robert-cameron/jenga_bot/embedded/end_eff_1.png

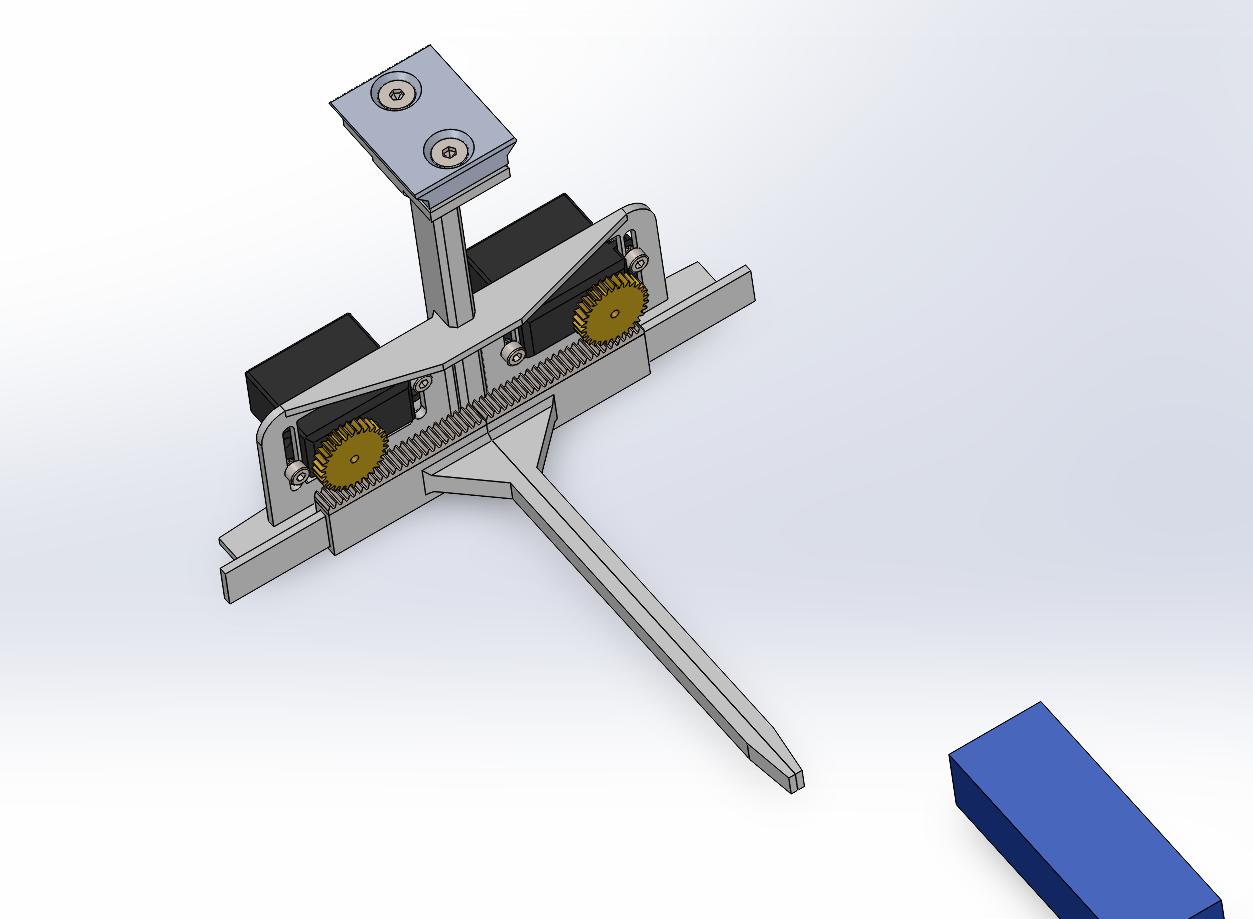
embedded/end_eff_1.png
