robert-cameron/jenga_bot/embedded/end_eff_2.png

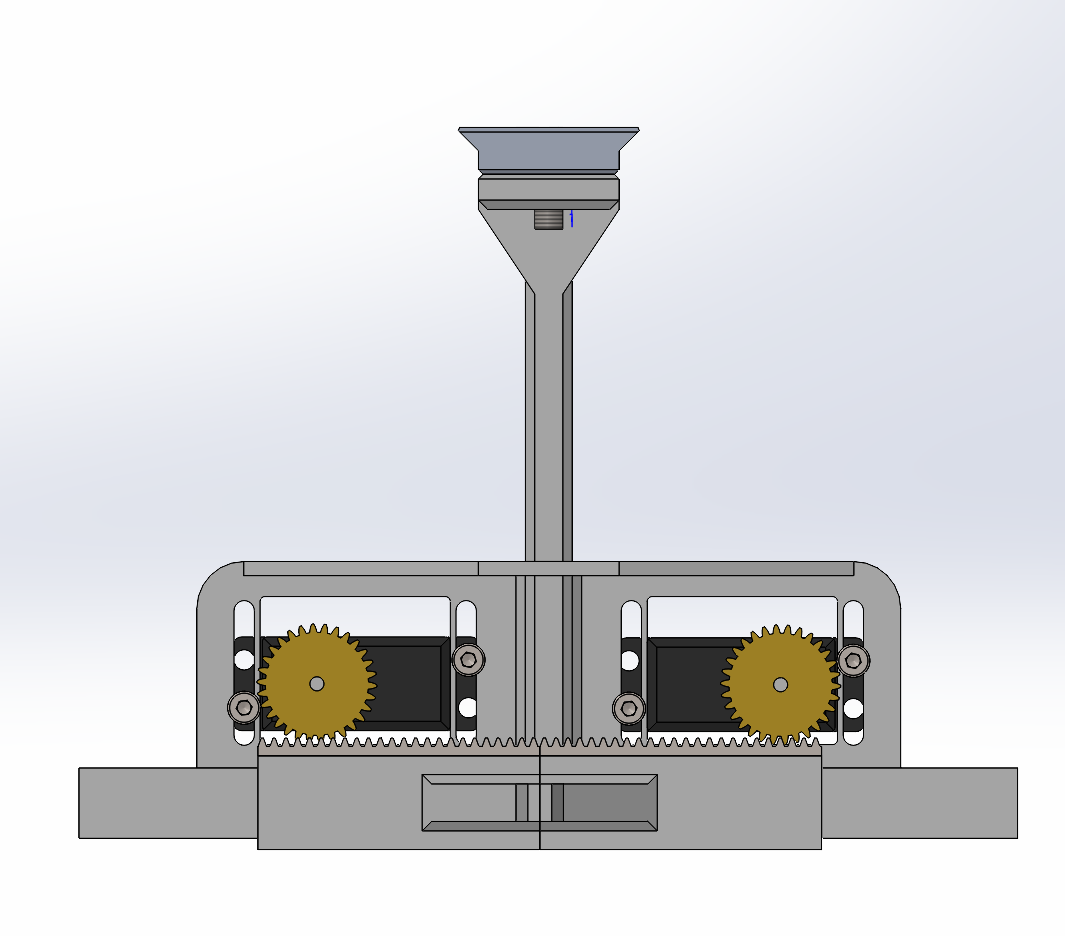
embedded/end_eff_2.png
