robert-cameron/jenga_bot/embedded/end_eff_3.png

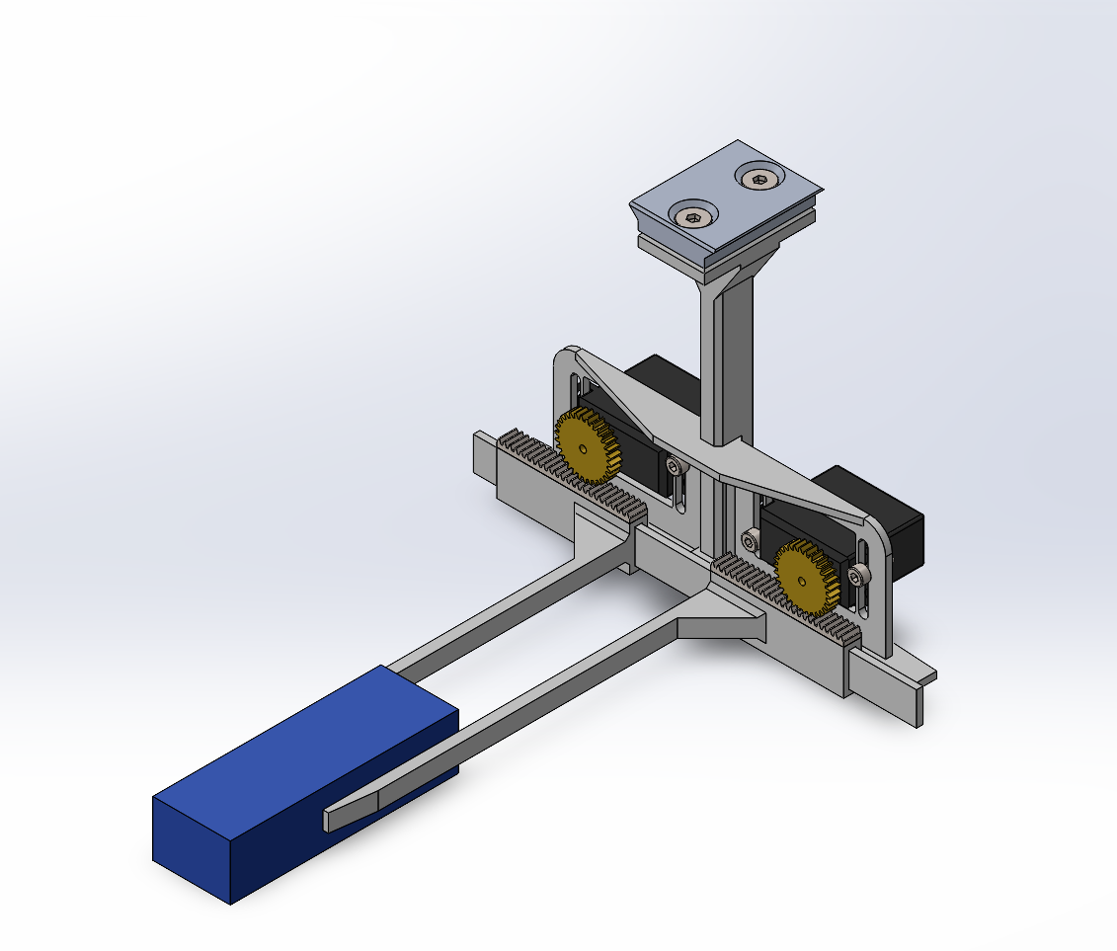
embedded/end_eff_3.png
