robert-cameron/jenga_bot/image/state_diagram_2.png

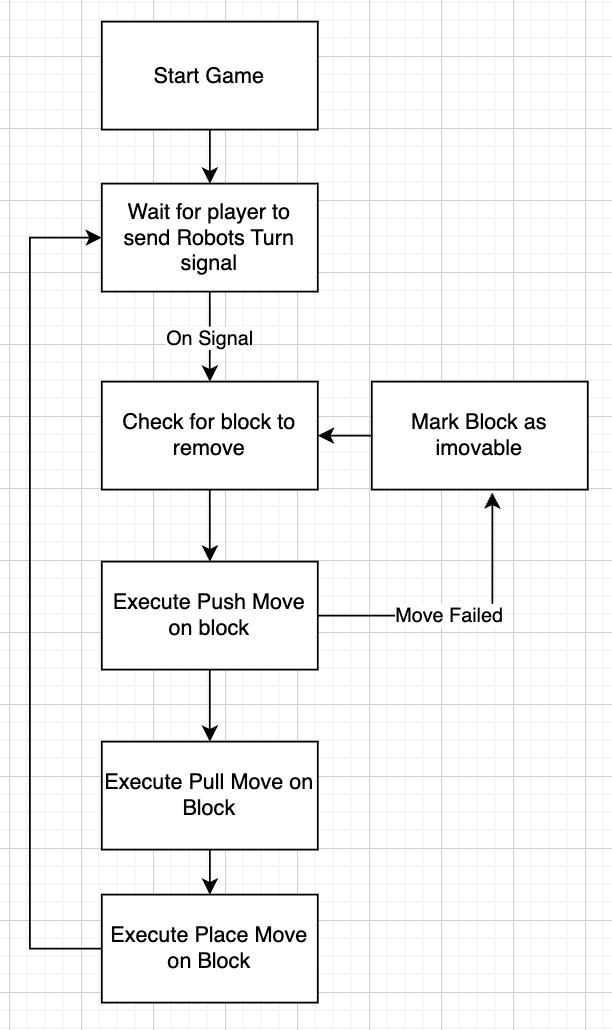
image/state_diagram_2.png
