robert-cameron/jenga_bot/solidworks/装配体3.SLDASM

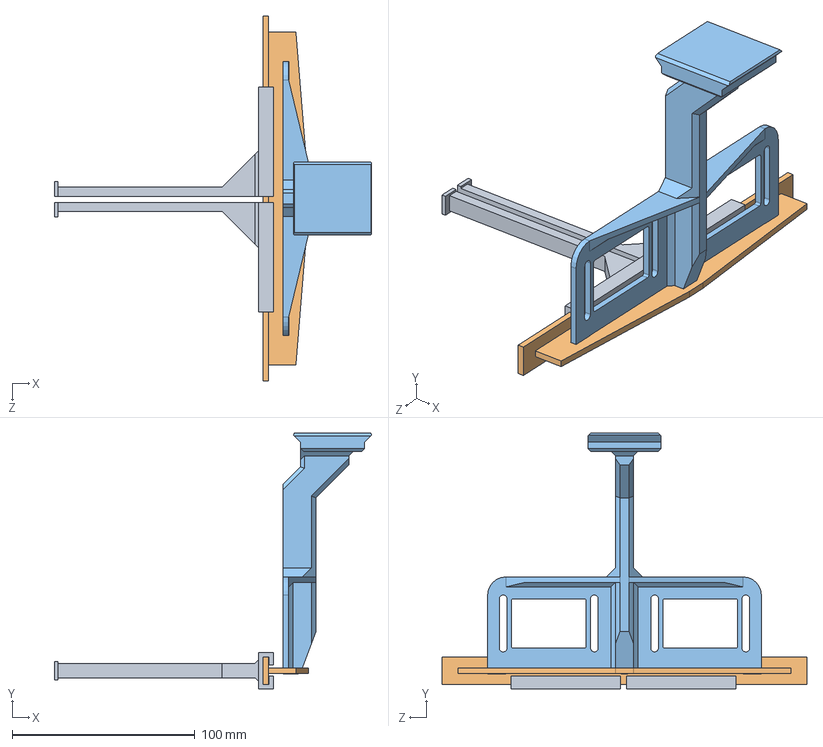
[picture p19: CAD file, 2025-11-05]
solidworks/装配体3.SLDASM
173.9 x 140.2 x 200.0 mm
body version 2
gripper x 2
