robert-cameron/jenga_bot/src/ur_description_custom/meshes/end_eff/assembly.stl

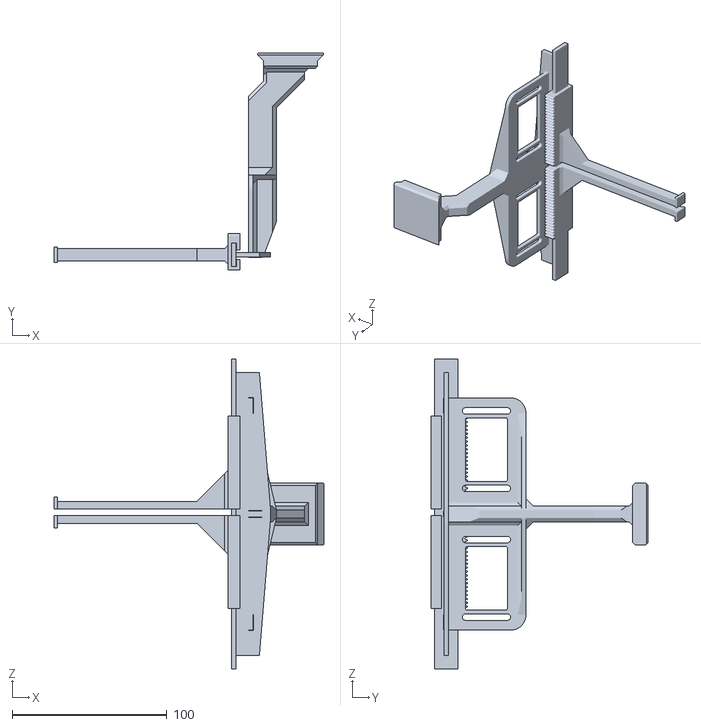
[picture p20: CAD file, 2025-11-05]
src/ur_description_custom/meshes/end_eff/assembly.stl
173.9 x 140.2 x 200.0
