robert-cameron/jenga_bot/solidworks/rack spur rectangular_gb.SLDPRT

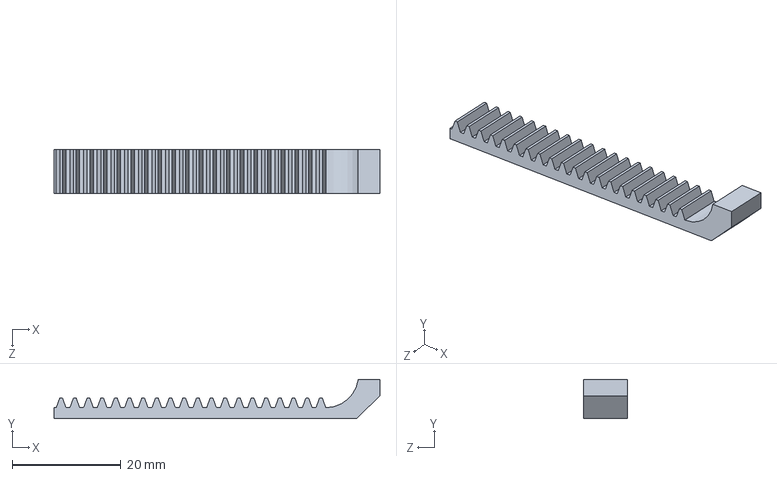
[picture p21: CAD file, 2025-11-05]
solidworks/rack spur rectangular_gb.SLDPRT
59.9 x 7.18 x 8.00 mm
