robert-cameron/jenga_bot/src/ur_description_custom/meshes/end_eff/collision model.STL

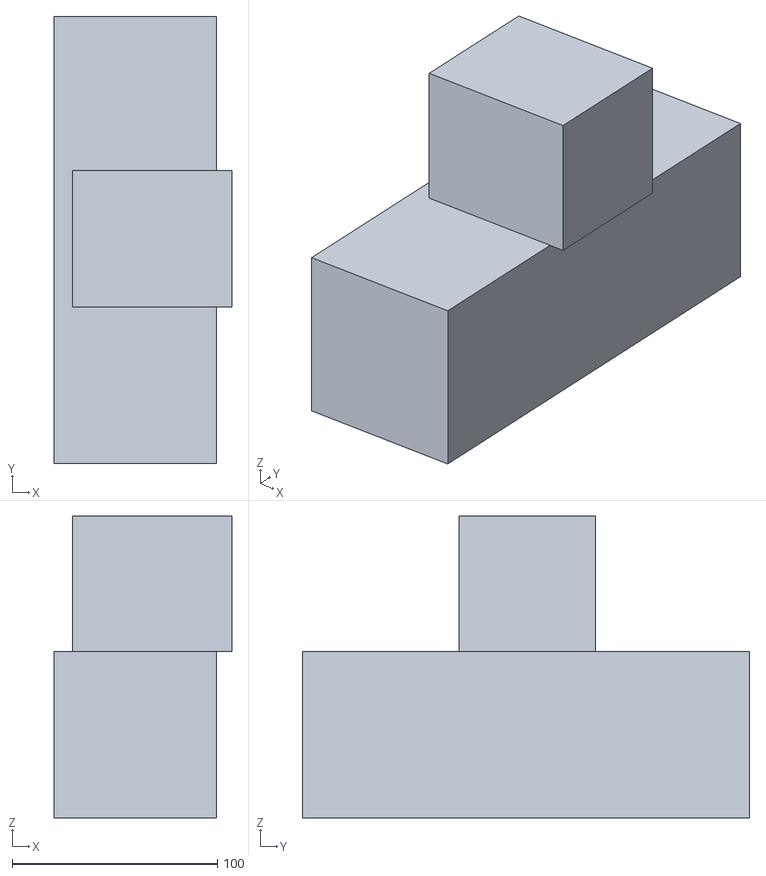
[picture p22: CAD file, 2025-11-05]
src/ur_description_custom/meshes/end_eff/collision model.STL
86.6 x 217.7 x 147.0
