robert-cameron/jenga_bot/src/ur_description_custom/meshes/end_eff_basic/base.stl

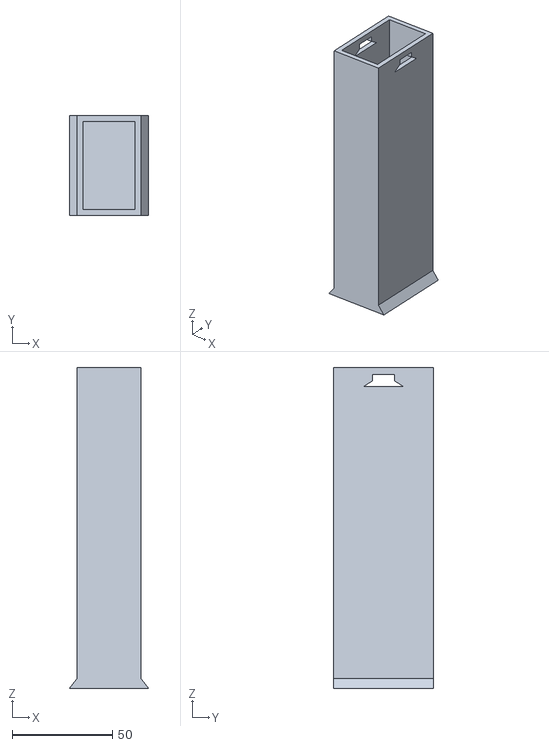
[picture p23: CAD file, 2025-10-22]
src/ur_description_custom/meshes/end_eff_basic/base.stl
39.6 x 50.0 x 159.9
