robert-cameron/jenga_bot/src/ur_description_custom/meshes/ur5e/collision/wrist1.stl

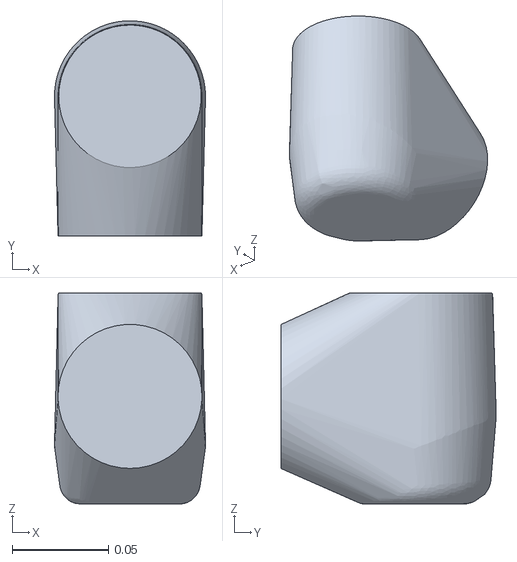
[picture p24: CAD file, 2025-10-22]
src/ur_description_custom/meshes/ur5e/collision/wrist1.stl
0.0787 x 0.112 x 0.11
