robert-cameron/jenga_bot/solidworks/body.SLDPRT

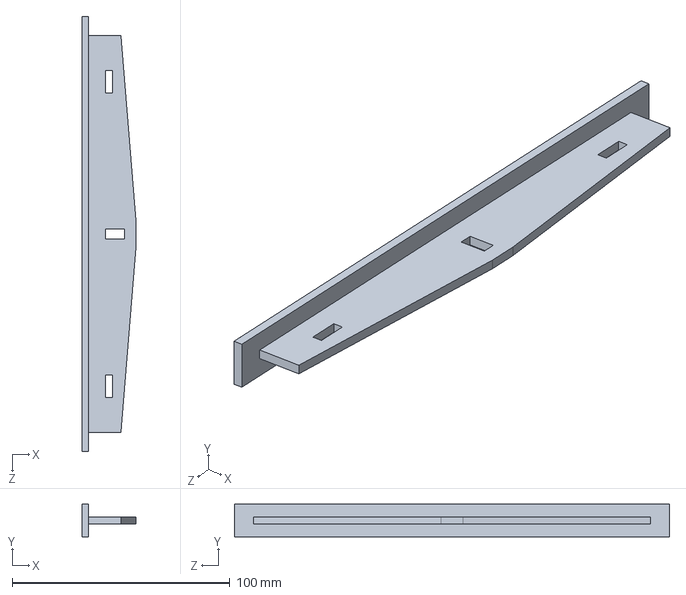
[picture p25: CAD file, 2025-11-05]
solidworks/body.SLDPRT
25.0 x 15.0 x 200.0 mm
