robert-cameron/jenga_bot/src/ur_description_custom/meshes/end_eff_basic/finger.stl

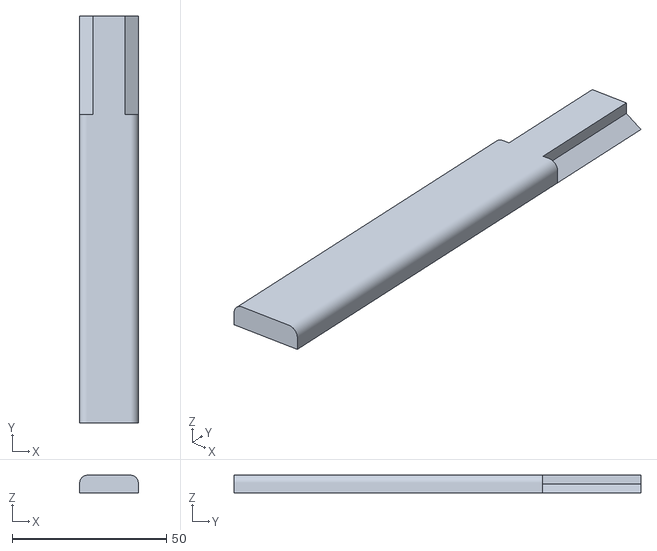
[picture p26: CAD file, 2025-10-22]
src/ur_description_custom/meshes/end_eff_basic/finger.stl
19.0 x 132.0 x 5.70
