robert-cameron/jenga_bot/src/ur_description_custom/meshes/ur5e/collision/upperarm.stl

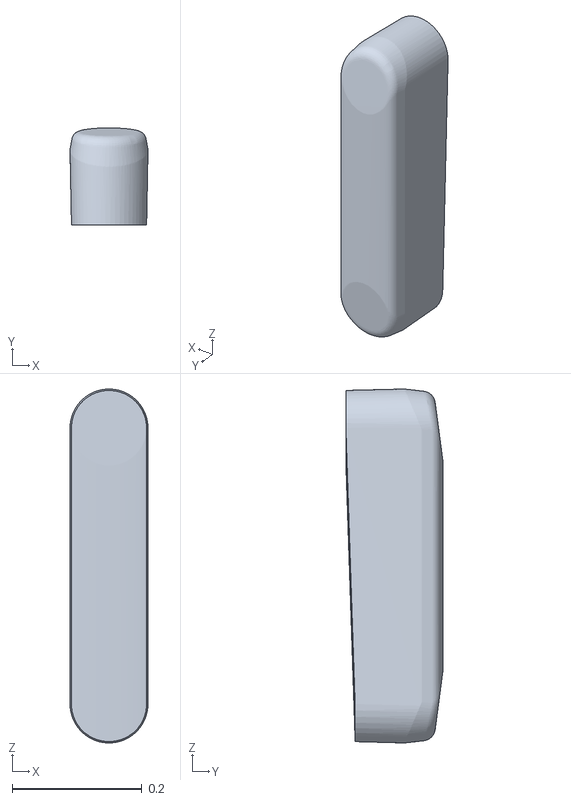
[picture p27: CAD file, 2025-10-22]
src/ur_description_custom/meshes/ur5e/collision/upperarm.stl
0.12 x 0.15 x 0.545
