robert-cameron/jenga_bot/src/ur_description_custom/SolidWorks_files/mount.SLDPRT

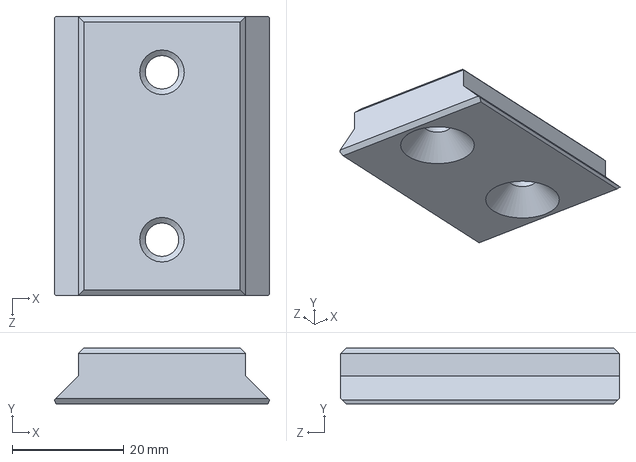
[picture p28: CAD file, 2025-10-29]
src/ur_description_custom/SolidWorks_files/mount.SLDPRT
38.6 x 10.0 x 50.0 mm
