robert-cameron/jenga_bot/src/ur_description_custom/meshes/ur5e/collision/wrist3.stl

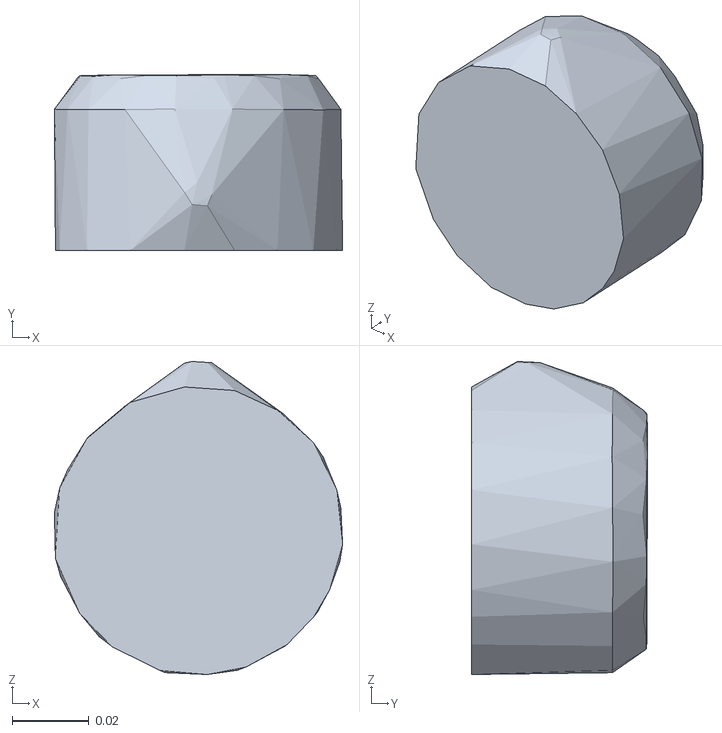
[picture p29: CAD file, 2025-10-22]
src/ur_description_custom/meshes/ur5e/collision/wrist3.stl
0.0751 x 0.0458 x 0.0816
