robert-cameron/jenga_bot/solidworks/body version 2.SLDPRT

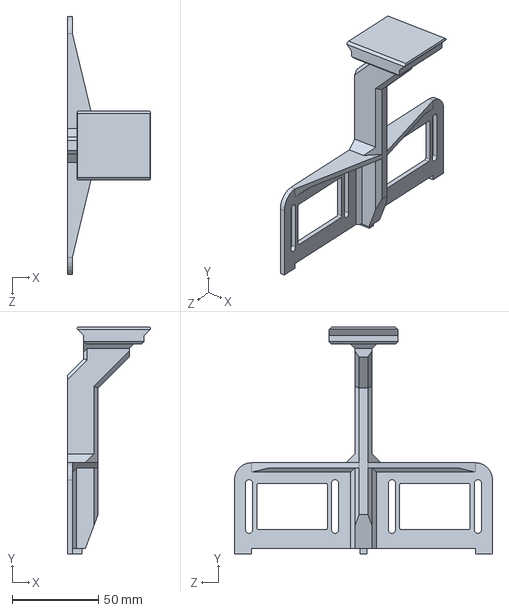
[picture p30: CAD file, 2025-11-05]
solidworks/body version 2.SLDPRT
48.5 x 131.9 x 150.0 mm
