robert-cameron/jenga_bot/src/ur_description_custom/meshes/ur5e/collision/base.stl

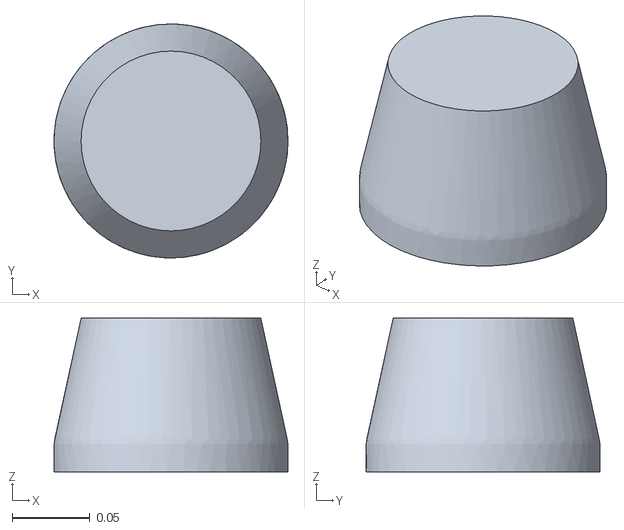
[picture p31: CAD file, 2025-10-22]
src/ur_description_custom/meshes/ur5e/collision/base.stl
0.151 x 0.151 x 0.0991
