robert-cameron/jenga_bot/src/ur_description_custom/SolidWorks_files/block.SLDPRT

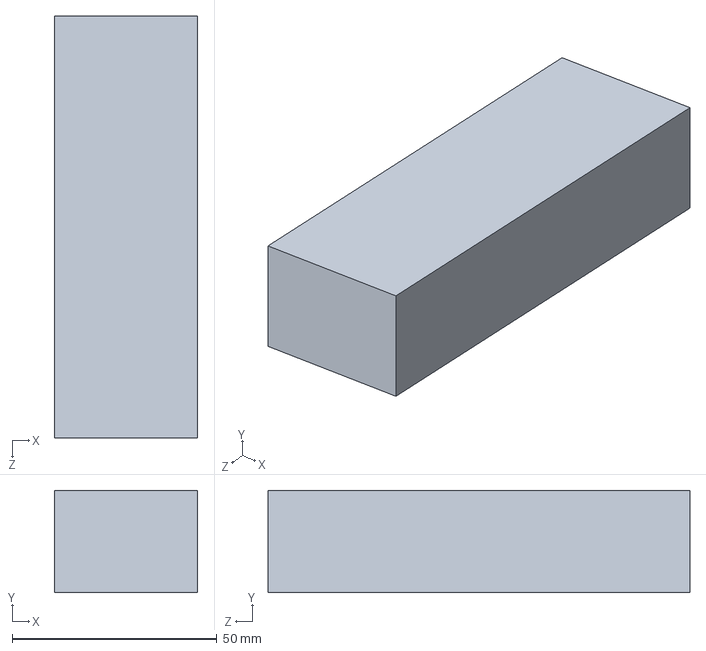
[picture p32: CAD file, 2025-10-29]
src/ur_description_custom/SolidWorks_files/block.SLDPRT
35.0 x 25.0 x 103.0 mm
