robert-cameron/jenga_bot/solidworks/gripper.SLDPRT

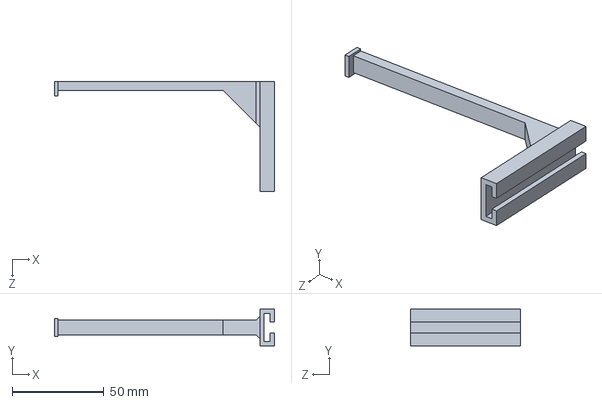
[picture p33: CAD file, 2025-11-05]
solidworks/gripper.SLDPRT
120.0 x 20.0 x 60.0 mm
