robert-cameron/jenga_bot/src/ur_description_custom/meshes/ur5e/collision/wrist2.stl

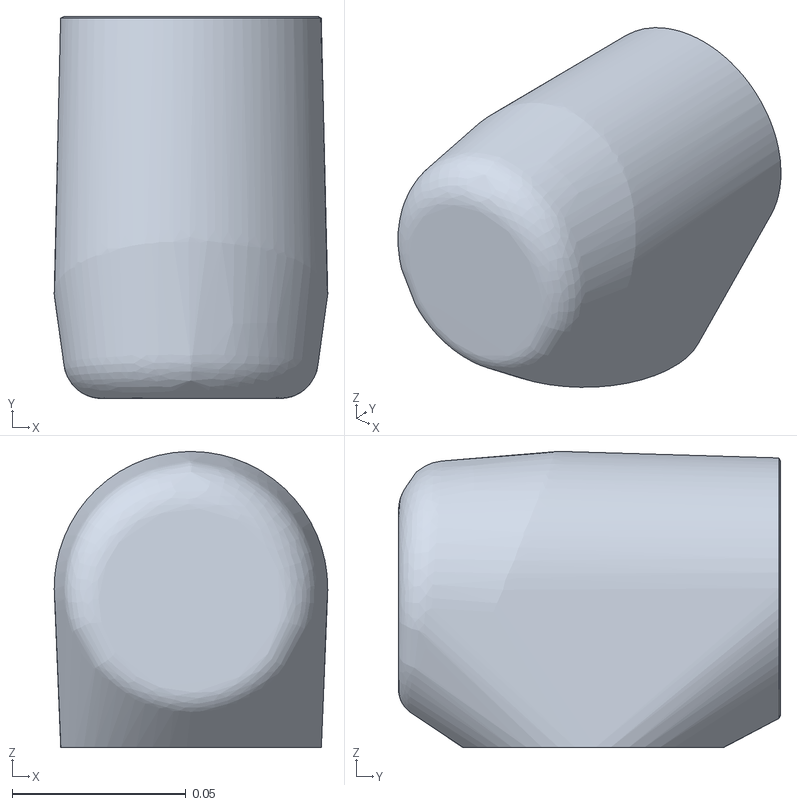
[picture p34: CAD file, 2025-10-22]
src/ur_description_custom/meshes/ur5e/collision/wrist2.stl
0.0787 x 0.11 x 0.0852
