robert-cameron/jenga_bot/src/ur_description_custom/SolidWorks_files/body 2.SLDPRT

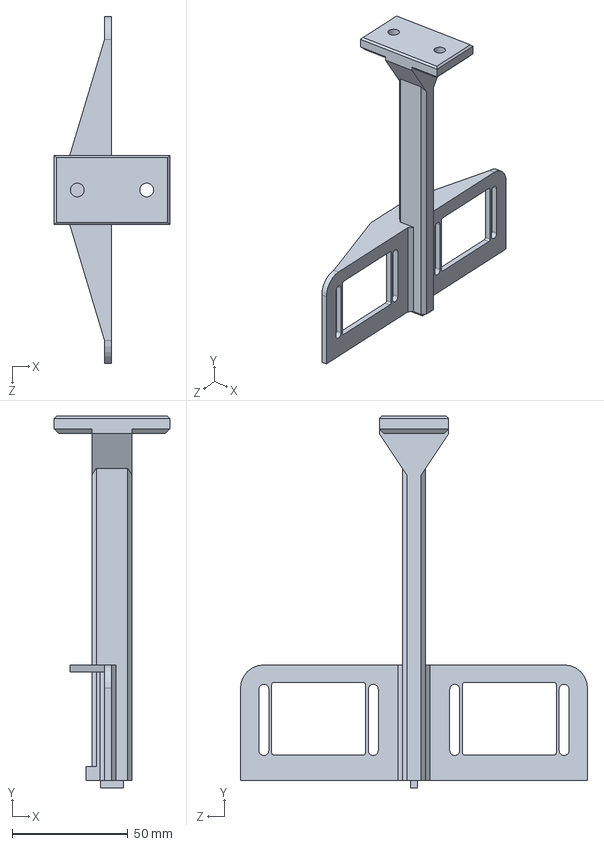
[picture p35: CAD file, 2025-10-29]
src/ur_description_custom/SolidWorks_files/body 2.SLDPRT
50.0 x 160.6 x 150.0 mm
