robert-cameron/jenga_bot/src/ur_description_custom/meshes/ur5e/collision/shoulder.stl

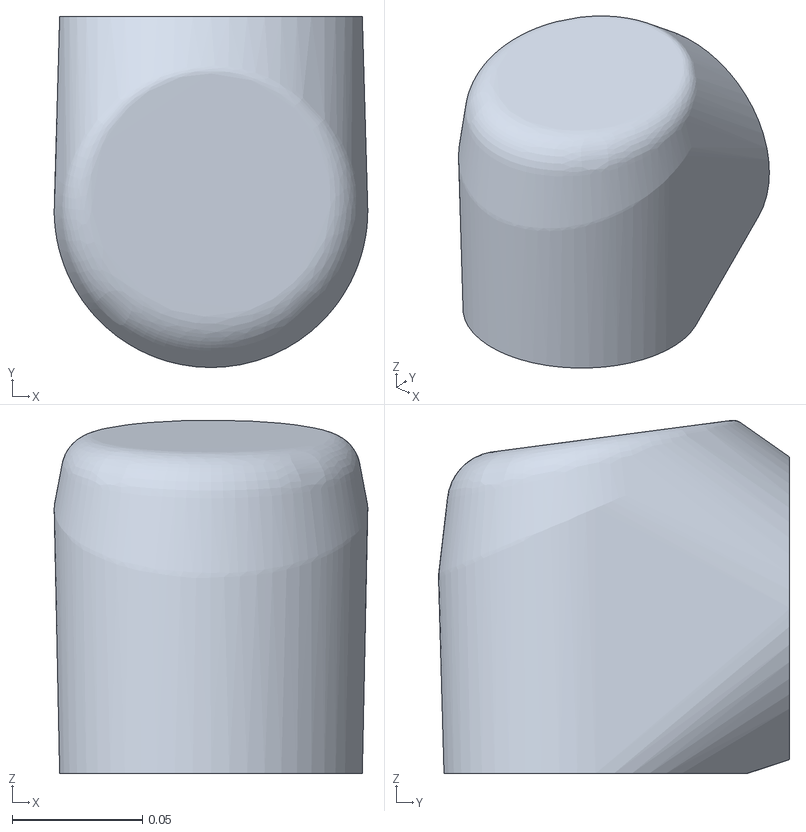
[picture p36: CAD file, 2025-10-22]
src/ur_description_custom/meshes/ur5e/collision/shoulder.stl
0.12 x 0.135 x 0.135
