robert-cameron/jenga_bot/src/ur_description_custom/SolidWorks_files/body.SLDPRT

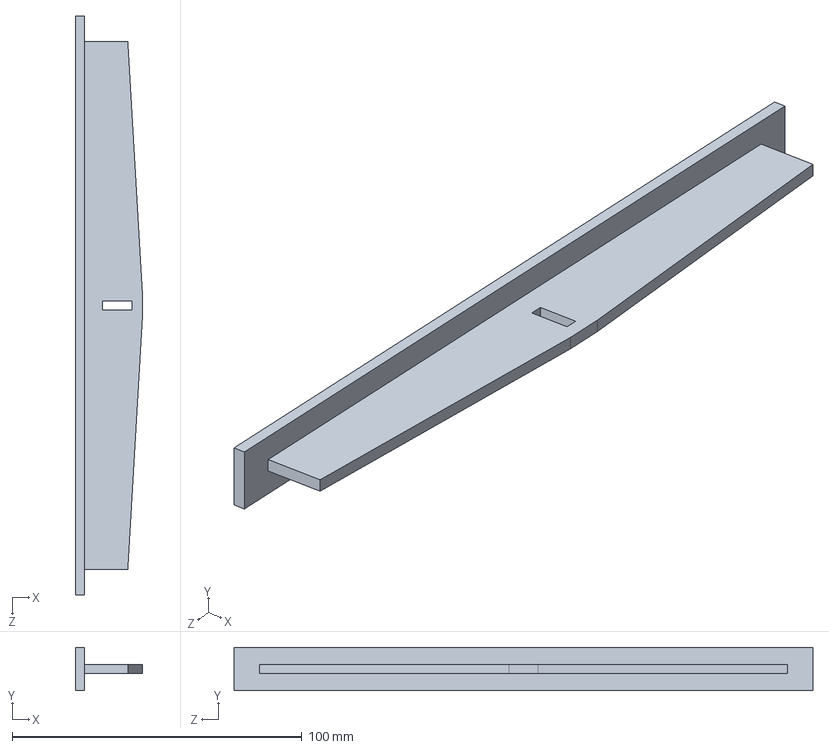
[picture p37: CAD file, 2025-10-29]
src/ur_description_custom/SolidWorks_files/body.SLDPRT
23.0 x 15.0 x 200.0 mm
