robert-cameron/jenga_bot/solidworks/GB - Spur gear 0.8M 30T 20PA 5FW ---S30A75H50L3.0N.SLDPRT

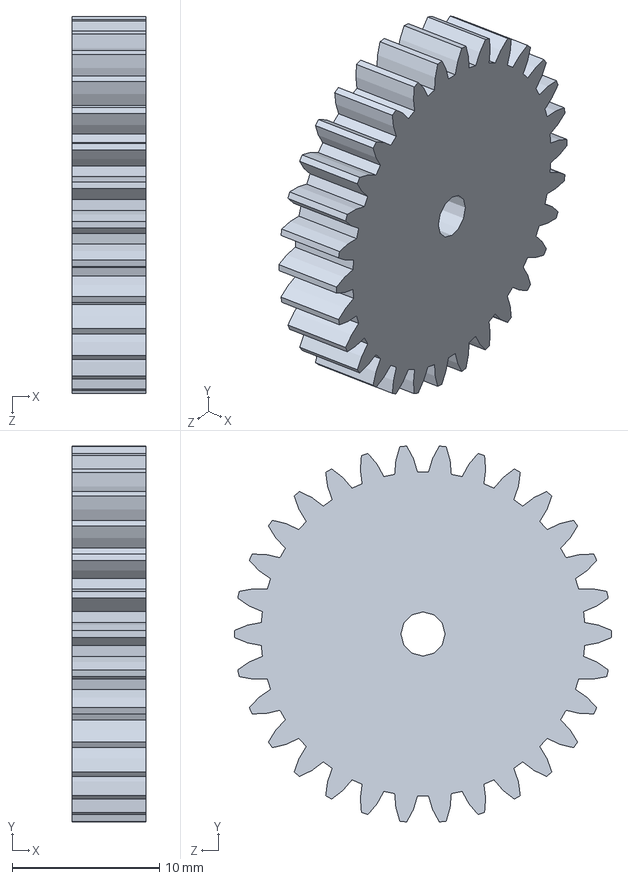
[picture p38: CAD file, 2025-10-29]
solidworks/GB - Spur gear 0.8M 30T 20PA 5FW ---S30A75H50L3.0N.SLDPRT
5.00 x 25.5 x 25.6 mm
