robert-cameron/jenga_bot/src/ur_description_custom/meshes/ur5e/collision/forearm.stl

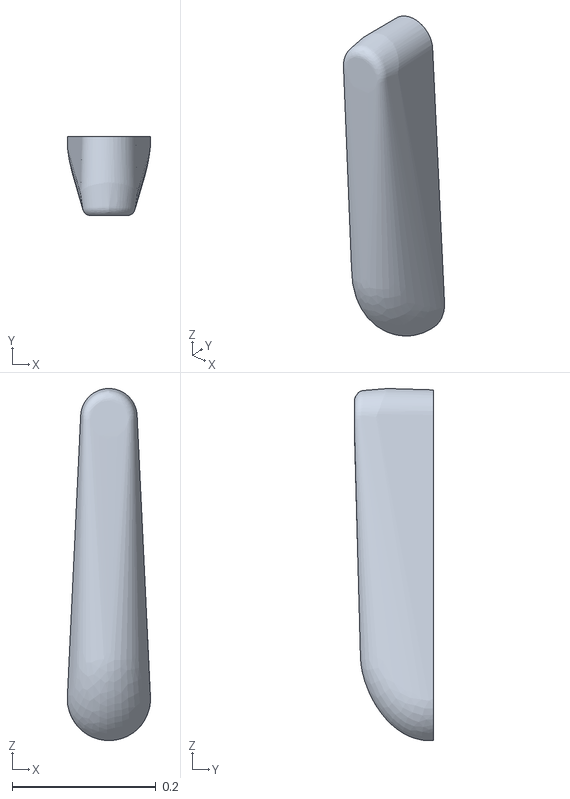
[picture p39: CAD file, 2025-10-22]
src/ur_description_custom/meshes/ur5e/collision/forearm.stl
0.116 x 0.11 x 0.489
