robert-cameron/jenga_bot/src/ur_description_custom/SolidWorks_files/gripper.SLDPRT

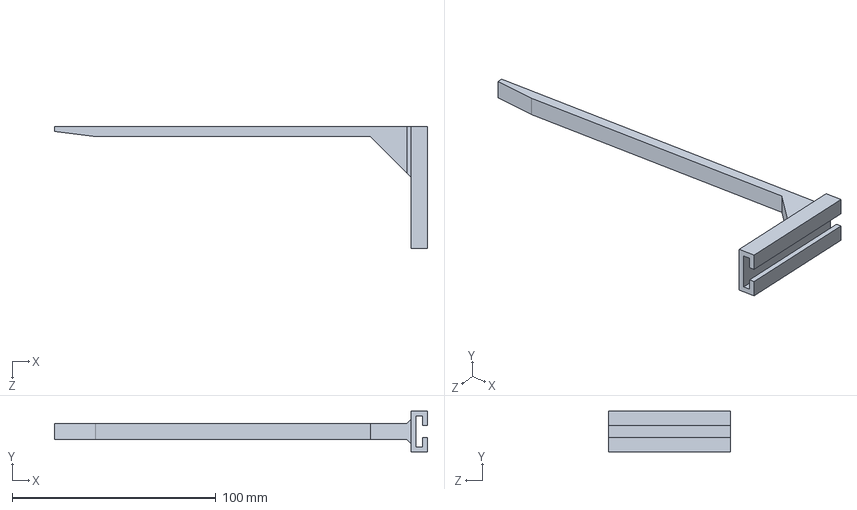
[picture p40: CAD file, 2025-10-29]
src/ur_description_custom/SolidWorks_files/gripper.SLDPRT
183.0 x 20.0 x 60.0 mm
