robert-cameron/jenga_bot/solidworks/servo.SLDPRT

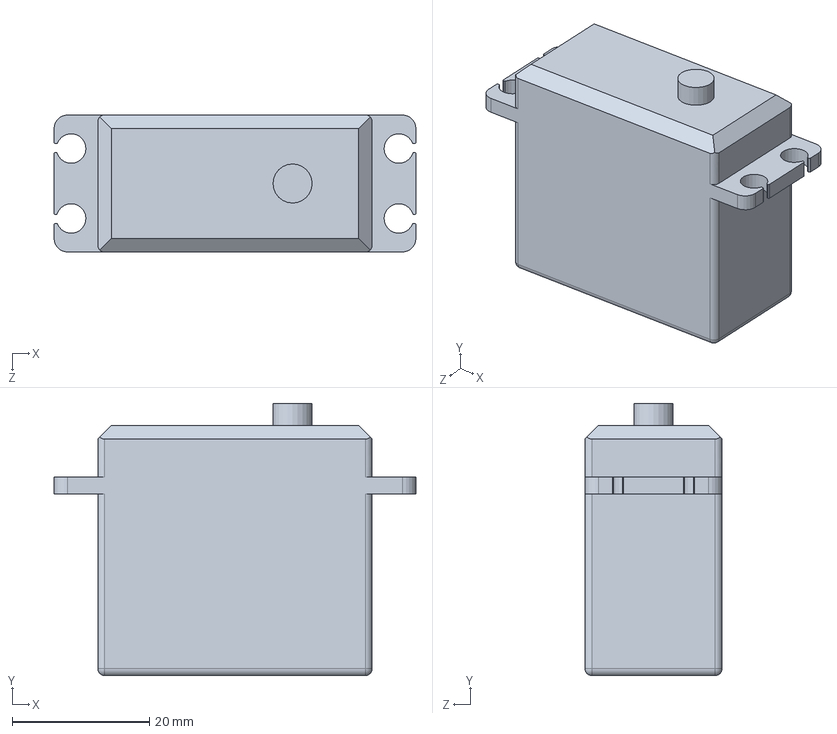
[picture p41: CAD file, 2025-10-29]
solidworks/servo.SLDPRT
52.8 x 39.7 x 20.0 mm
