robert-cameron/jenga_bot/src/ur_description_custom/SolidWorks_files/assembly 1.SLDASM

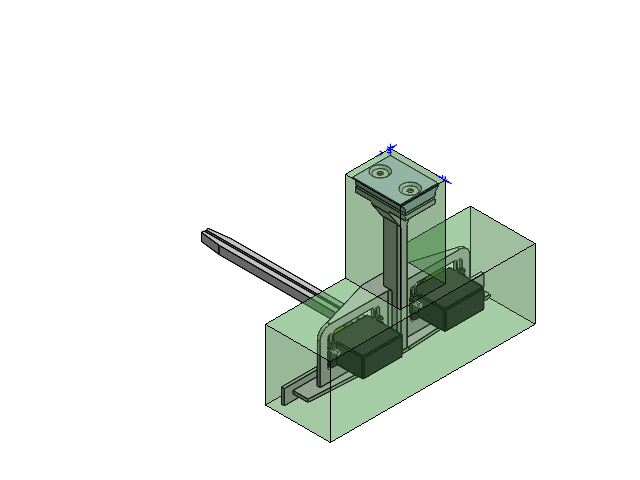
[picture p42: CAD file, 2025-10-29]
src/ur_description_custom/SolidWorks_files/assembly 1.SLDASM
mount
servo x 2
gripper x 2
spur gear_gb x 2
rack spur rectangular_gb x 2
hexagon socket head cap screw_as x 4
hex lobular socket ctsk screws gb x 2
Part1^assembly 1
Part2^assembly 1
collision model
