robert-cameron/jenga_bot/solidworks/assem.SLDASM

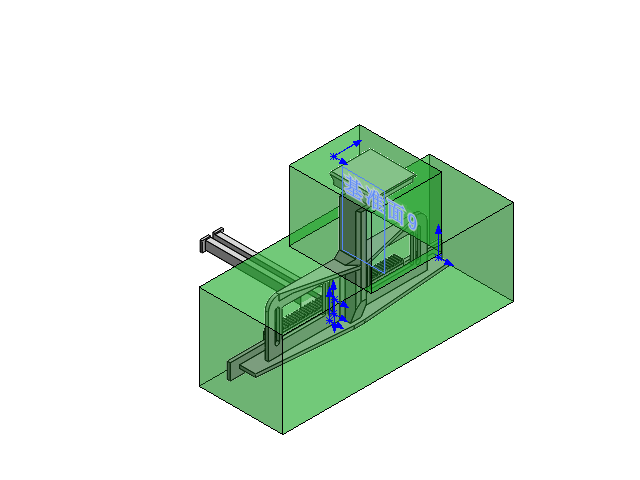
[picture p43: CAD file, 2025-11-05]
solidworks/assem.SLDASM
body version 2
gripper x 2
rack spur rectangular_gb2 x 2
零件1^assem
