robert-cameron/jenga_bot/(list of files, cad)

Other CAD files:
src/ur_description_custom/SolidWorks_files/hexagon socket head cap screw_as.SLDPRT
