robert-cameron/jenga_bot/(commit log)

2025-10-21 implement basic manipulation
    [controllers.yaml, ur.srdf.xacro, ur_macro.srdf.xacro, ur_servo.yaml]
2025-10-22 add robot description
    [base.stl, forearm.stl, joint_limits.yaml, shoulder.stl, upperarm.stl, ur.ros2_control.xacro, ur.urdf.xacro, ur_common.xacro]
2025-10-22 add basic end effector
    [base.stl, end_eff_basic.xacro, finger.stl, ur.urdf.xacro]
2025-10-28 Collision model added.
    [collision model.SLDPRT]
2025-10-29 rotate end effector
    [ur.urdf.xacro]
2025-10-29 Simple assembled model uploaded.
    [Assem.STL]
2025-10-30 added force sensor
2025-10-30 Add pressure sensor functionality with calibration
2025-10-30 Update debug messages for auto-calibration
2025-10-30 End effector model v2.0 uploaded.
    Changed the direction of the mount, made the servo notch wider.
    [assembly 1.STL]
2025-10-30 Refactor pressure sensor calibration logic
2025-11-01 add new end effector
    [assembly.stl, body 2 1.stl, body.stl, collision.stl, end_eff_detailed.xacro, gripper.stl, ur.urdf.xacro]
2025-11-01 align moveit with end effector
    [end_eff_detailed.xacro, ur.urdf.xacro]
2025-11-02 add tf support for movement actions
    [ur.urdf.xacro, ur_macro.srdf.xacro]
2025-11-05 Assembly version 3 uploaded.
    [assem.STL]
2025-11-05 collision model updated.
    [collision model.STL]
2025-11-07 update end eff urdf
    [assembly.stl, collision.stl, end_eff_detailed.xacro, ur.urdf.xacro]
2025-11-11 tune end effector dimensions
    [ur.urdf.xacro]
2025-11-12 Refactor servo control logic and command handling
2025-11-17 GUI prototype uploaded
2025-11-17 add camera calibration script
2025-11-19 Got Tower point in base_link frame
2025-11-25 chain push, pull, place moves together
2025-11-25 update approach face tolerance
    [approach_move_action.hpp]
2025-11-26 fix end eff height in model
    [end_eff_detailed.xacro, ur.urdf.xacro]
2025-11-26 Major change in GUI node
    I change the pose array source from fake data to real data by subscribe the pose arrays from camera detect node.
2025-12-01 Add tower filtering
2025-12-01 add calibration point
2025-12-01 Rename 屏幕截图 2025-12-02 024002.png to endeff1
2025-12-04 Add Vision running and calibration
2025-12-05 Rename 屏幕截图 2025-12-05 162649.png to endeffdrawing.png
